STEMTera/STEMTera-Breadboard-B328/Enclosure/stemtera9_bottom_cover_part1.stl

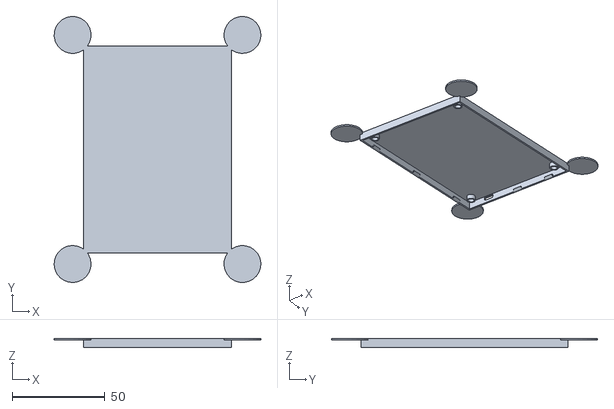
[picture p1: CAD file, 2017-02-02]
Enclosure/stemtera9_bottom_cover_part1.stl
111.8 x 143.8 x 5.10
