STEMTera/STEMTera-Breadboard-B328/(list of files, cad)

Other CAD files:
Enclosure/models/0805.skp
Enclosure/models/C0603.skp
Enclosure/models/C1206.skp
Enclosure/models/CONN_JACK_PJ-051A-SINGLE_SIDED.skp
Enclosure/models/CONN_JACK_PJ-051A.skp
Enclosure/models/CONN_USB_MICRO_B_10118193-0001LF.skp
Enclosure/models/CSTCE_V.skp
Enclosure/models/CT6032.skp
Enclosure/models/CT_CN0603.skp
Enclosure/models/DPACK.skp
Enclosure/models/HC49US-SMD-2.5MM.skp
Enclosure/models/HC49US-SMD.skp
Enclosure/models/L1812.skp
Enclosure/models/LED3MM.skp
Enclosure/models/LED3MMRND.skp
Enclosure/models/MINIMELF.skp
Enclosure/models/PUSH_BUTTON-ESWITCH_TL6120DF300QG.skp
Enclosure/models/QFN32.skp
Enclosure/models/R0603.skp
Enclosure/models/R1206.skp
Enclosure/models/SO08-150.skp
Enclosure/models/SO14.skp
Enclosure/models/SOIC08_3.8MM.skp
Enclosure/models/SOT-23.skp
Enclosure/models/SOT23-DBV.skp
Enclosure/models/SOT89.skp
Enclosure/models/SSOP28.skp
Enclosure/models/TQFP32-7MM_0.8MM.skp
Enclosure/models/TSSOP14.skp
