STEMTera/STEMTera-Breadboard-B328/Breadboard.pdf

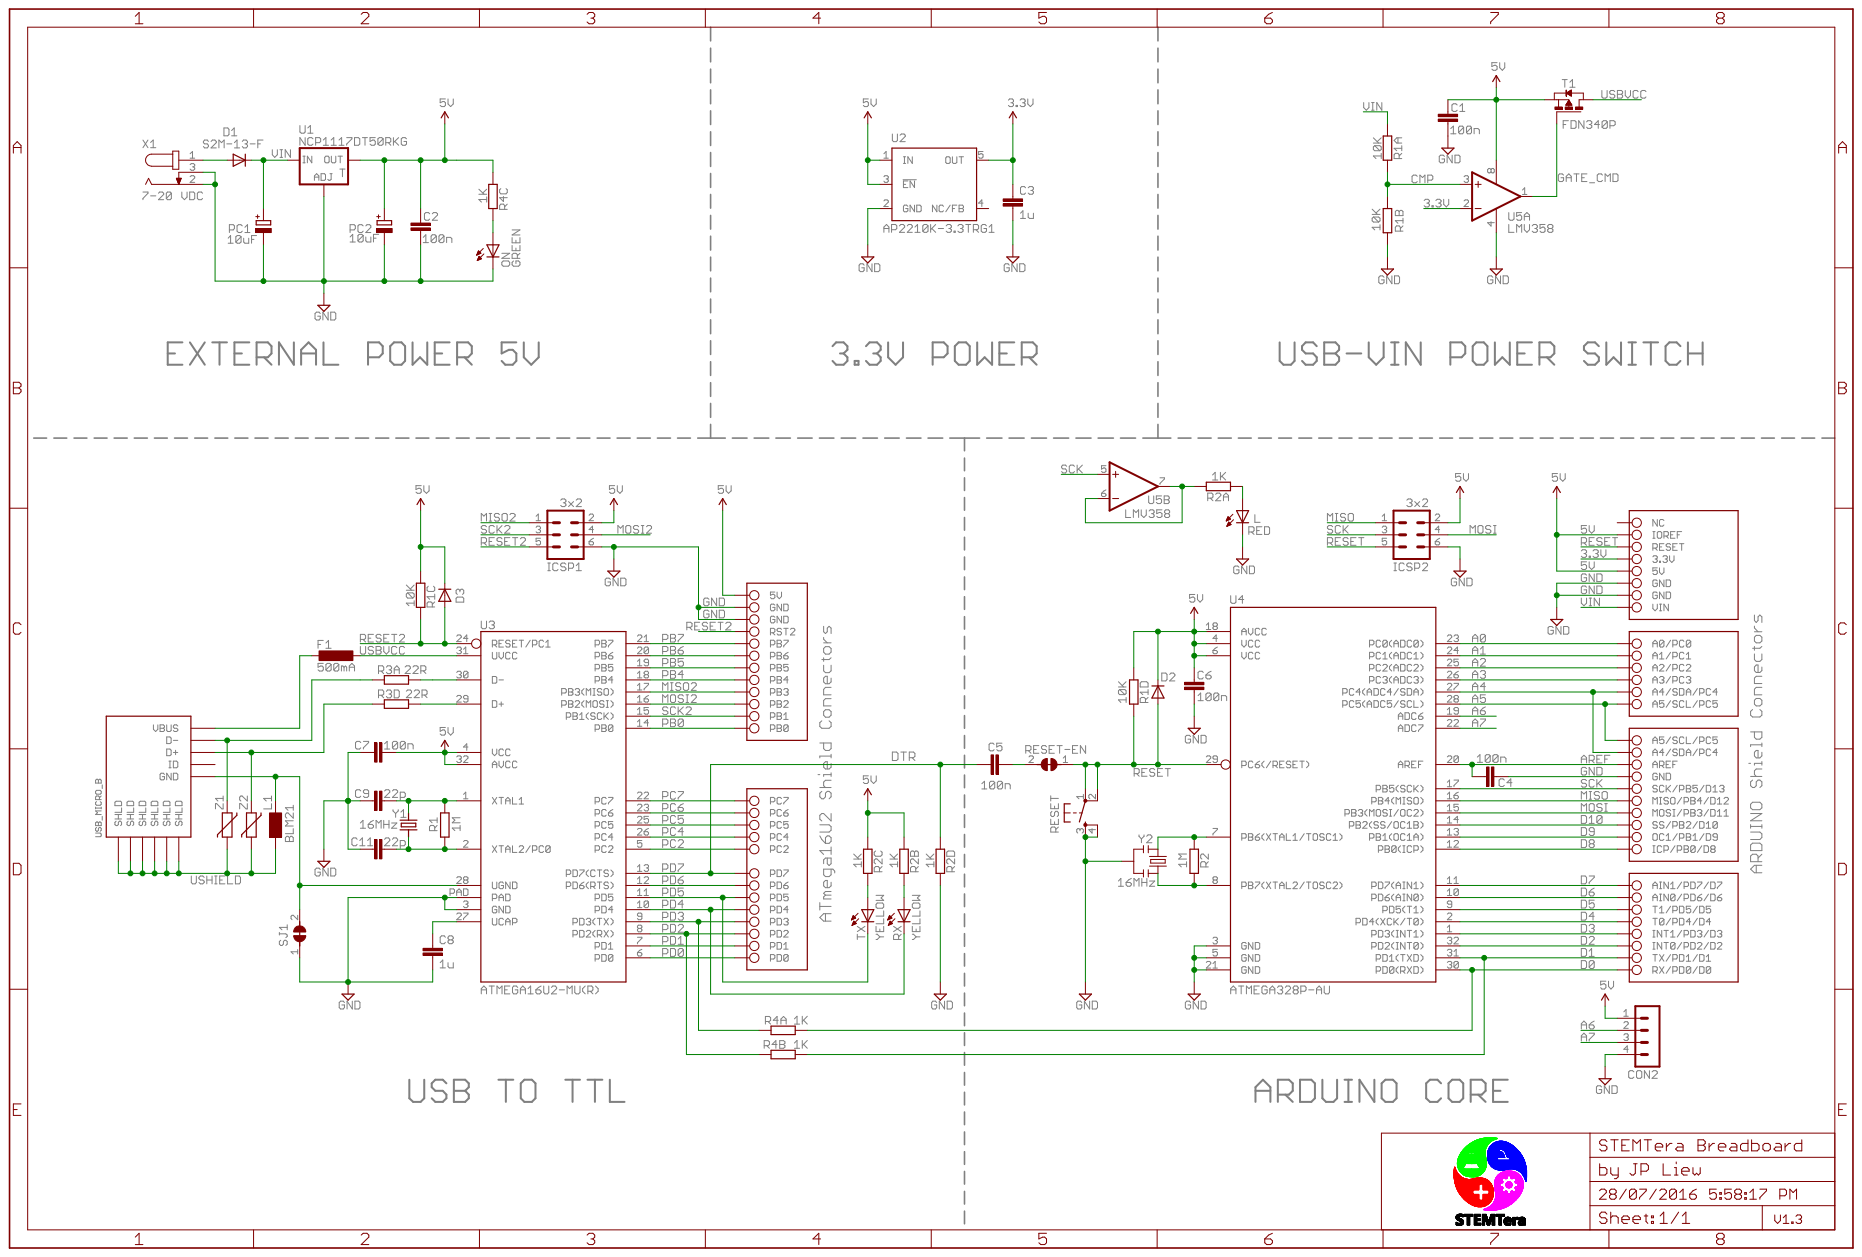
[picture p2: page 1]
