STEMTera/STEMTera-Breadboard-B328/Enclosure/STEMTera Breadboard Bottom Dimension.pdf

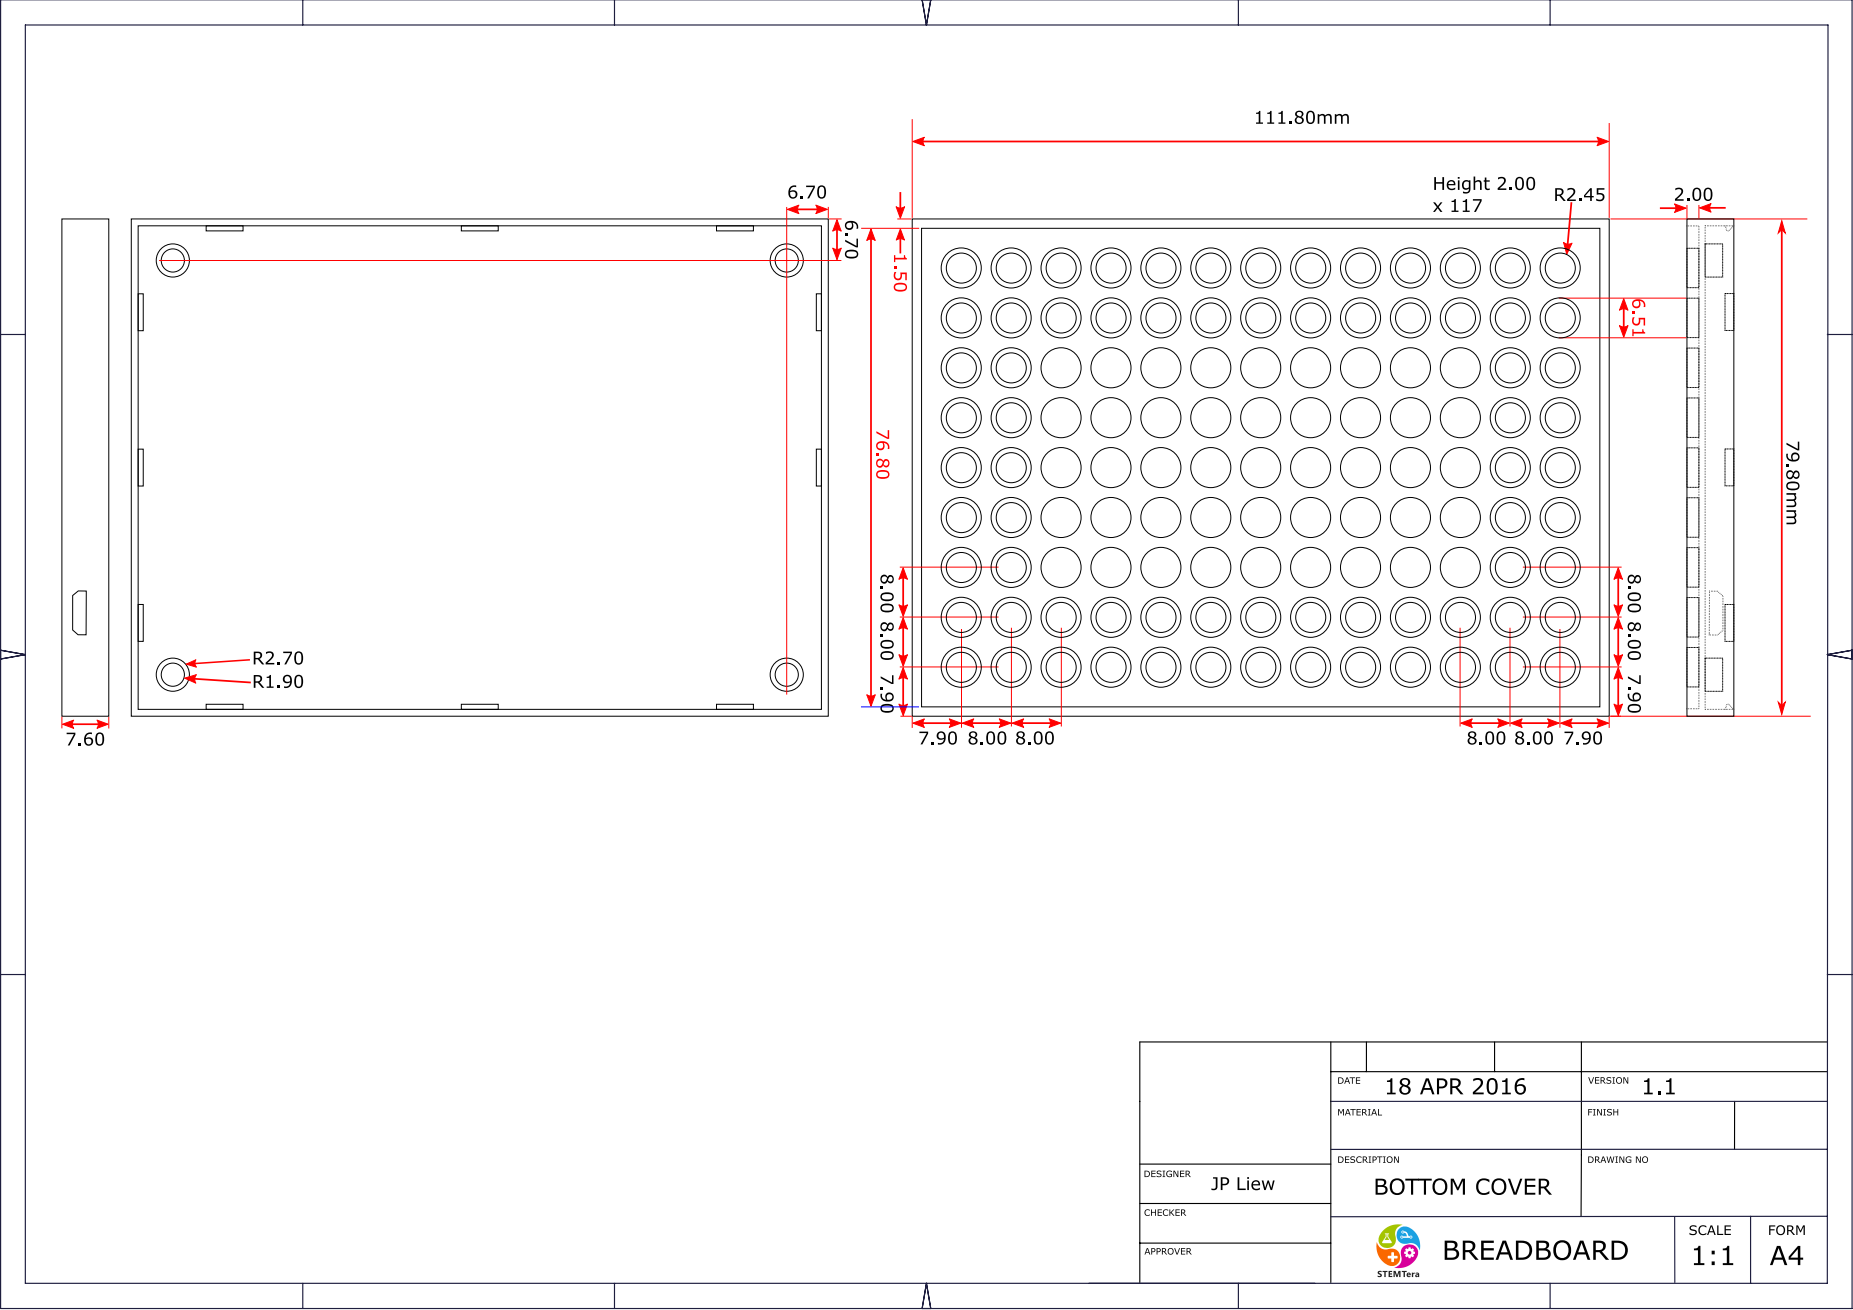
[picture p3: page 1]
