STEMTera/STEMTera-Breadboard-B328/Enclosure/STEMTera Breadboard Text.pdf

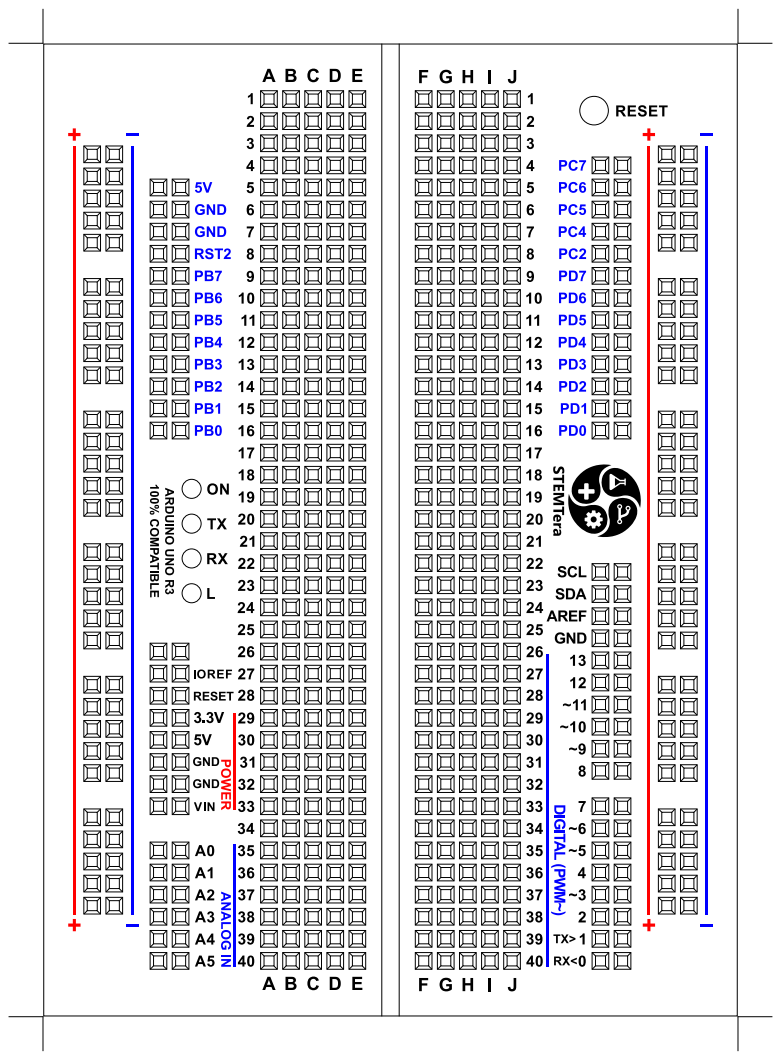
[picture p4: page 1]
