STEMTera/STEMTera-Breadboard-B328/Enclosure/STEMTera Breadboard Top Dimension.pdf

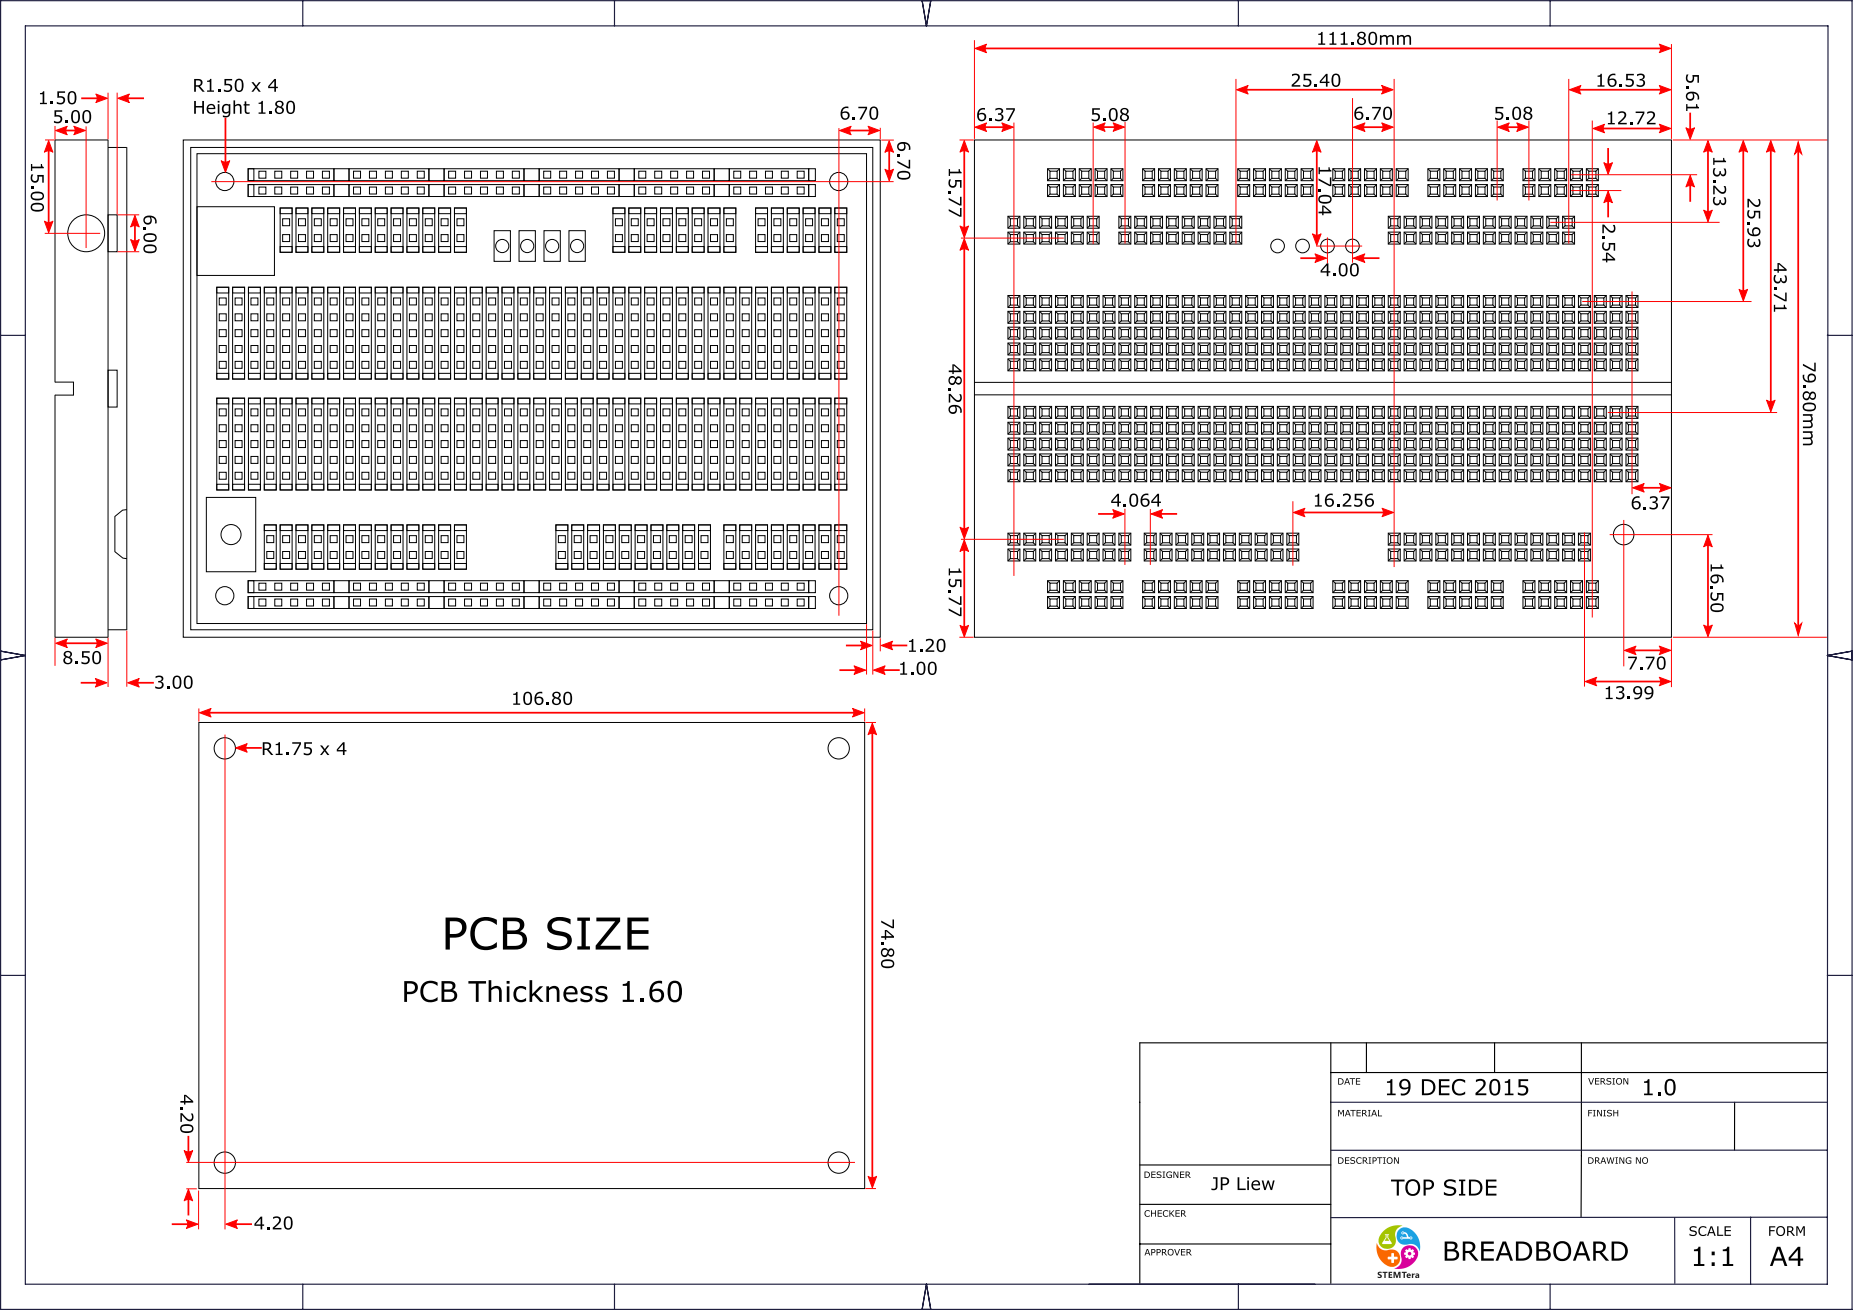
[picture p5: page 1]
