STEMTera/STEMTera-Breadboard-B328/Breadboard.brd

## EAGLE design Breadboard.brd (2017-02-02)

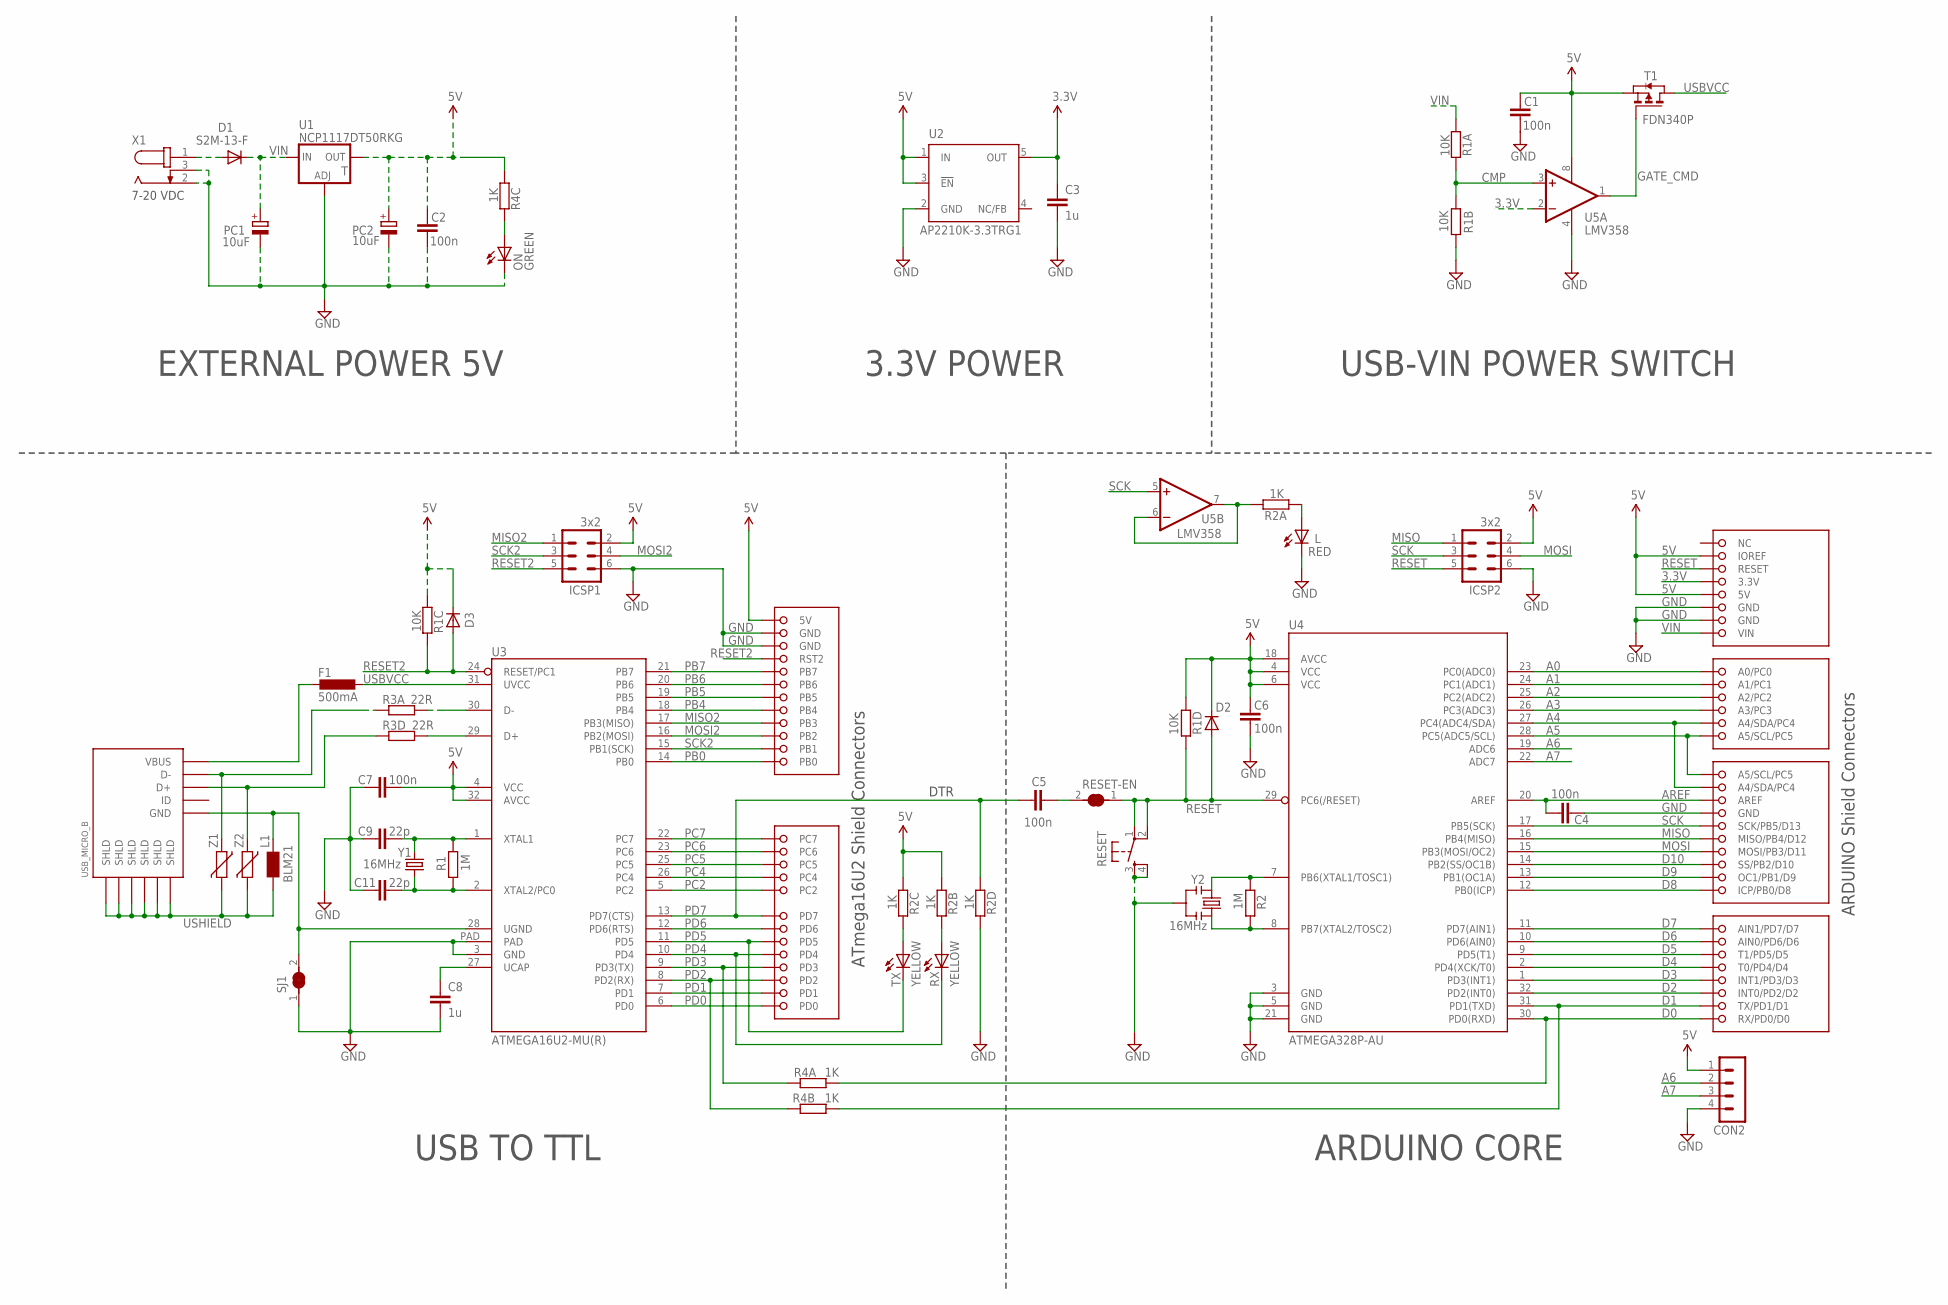
[picture p6: schematic Breadboard.sch]

Parts:
C1, C2, C4, C5, C6, C7: 100n; C0603; MPN CC0603KRX7R9BB104
C3, C8: 1u; C0603; MPN CC0603KRX5R6BB105
C9, C11: 22p; C0603; MPN 06035A220JAT2A
CON1: STEMTERA; MPN NOT INSTALLED
CON2: MA04-1; MA04-1-SMD
D1: S2M-13-F; SMB; MPN S2M-13-F
D2, D3: CD1206-S01575; MINIMELF; MPN CD1206-S01575
F1: 500mA; L1812; MPN MF-MSMF050-2
ICSP1, ICSP2: 3x2; MA03-2; MPN NOT INSTALLED
L: RED; LED3MM; MPN L-13ID
L1: BLM21; 0805; MPN BLM21PG221SN1D
ON: GREEN; LED3MM; MPN L-13GD
PC1, PC2: 10uF; CT6032; MPN T491C106M025AT7280
R1, R2: 1M; R0603; MPN RC0603FR-071ML
R1A, R1B, R1C, R1D: 10K; R0603; MPN RC0603FR-0710KL
R2A, R2B, R2C, R2D, R4A, R4B, R4C: 1K; R0603; MPN RC0603FR-071KL
R3A, R3D: 22R; R0603; MPN RC0603FR-0722RL
RESET: PUSH_BUTTON-ESWITCH_TL6120DF300QG
RESET-EN: Jumper; SOLDER_JUMPER_NC; MPN NOT INSTALLED
RX: YELLOW; LED3MM; MPN L-13YD
SJ1: Jumper; SOLDER_JUMPER_NC; MPN NOT INSTALLED
T1: FDN340P; SOT-23; MPN FDN340P
TX: YELLOW; LED3MM; MPN L-13YD
U1: NCP1117DT50RKG; DPACK; MPN NCP1117DT50RKG
U2: AP2210K-3.3TRG1; SOT23-DBV; MPN AP2210K-3.3TRG1
U3: ATMEGA16U2-MU(R); QFN32; MPN ATMEGA16U2-MU
U4: ATMEGA328P-AU; TQFP32-7MM_0.8MM; MPN ATmega328P-AUR
U5: LMV358; SOIC08_3.8MM; MPN LMV358SG-13
USB_MICRO_B: CONN_USB-FCI_10118193-0001LF; CONN_USB_MICRO_B_10118193-0001LF; MPN 10118193-0001LF
X1: CONN_JACK-SINGLE_SIDED; CONN_JACK_PJ-051A-SINGLE_SIDED
Y1: 16MHz; HC49US-SMD-2.5MM; MPN ABLS3-16.000MHZ-D4Y-T
Y2: 16MHz; CSTCE_V; MPN CSTCE16M0V53-R0
Z1, Z2: VARISTORCN0603; CT/CN0603; MPN CG0603MLC-05E

Connections:
3.3V: C3.1, CON1.3.3V, U2.5 (OUT), U5.2 (-IN)
5V: C1.2, C2.2, C6.2, C7.2, CON1.5V, CON1.5V@11 (5V), CON1.IOREF, CON2.1, D2.C, D3.C, ICSP1.2, ICSP2.2, PC2.+, R1C.2, R1D.2, R2B.2, R2C.2, R4C.2, T1.2 (S), U1.4 (OUT), U2.1 (IN), U2.3 (!EN), U3.4 (VCC), U3.32 (AVCC), U4.4 (VCC), U4.6 (VCC), U4.18 (AVCC), U5.8 (V+)
A0: CON1.A0 (A0/PC0), U4.23 (PC0(ADC0))
A1: CON1.A1 (A1/PC1), U4.24 (PC1(ADC1))
A2: CON1.A2 (A2/PC2), U4.25 (PC2(ADC2))
A3: CON1.A3 (A3/PC3), U4.26 (PC3(ADC3))
A4: CON1.A4@1 (A4/SDA/PC4), CON1.A4@2 (A4/SDA/PC4), U4.27 (PC4(ADC4/SDA))
A5: CON1.A5@1 (A5/SCL/PC5), CON1.A5@2 (A5/SCL/PC5), U4.28 (PC5(ADC5/SCL))
A6: CON2.2, U4.19 (ADC6)
A7: CON2.3, U4.22 (ADC7)
AREF: C4.2, CON1.AREF, U4.20 (AREF)
CMP: R1A.1, R1B.2, U5.3 (+IN)
D0: CON1.D0 (RX/PD0/D0), R4A.2, U4.30 (PD0(RXD))
D1: CON1.D1 (TX/PD1/D1), R4B.2, U4.31 (PD1(TXD))
D2: CON1.D2 (INT0/PD2/D2), U4.32 (PD2(INT0))
D3: CON1.D3 (INT1/PD3/D3), U4.1 (PD3(INT1))
D4: CON1.D4 (T0/PD4/D4), U4.2 (PD4(XCK/T0))
D5: CON1.D5 (T1/PD5/D5), U4.9 (PD5(T1))
D6: CON1.D6 (AIN0/PD6/D6), U4.10 (PD6(AIN0))
D7: CON1.D7 (AIN1/PD7/D7), U4.11 (PD7(AIN1))
D8: CON1.D8 (ICP/PB0/D8), U4.12 (PB0(ICP))
D9: CON1.D9 (OC1/PB1/D9), U4.13 (PB1(OC1A))
D10: CON1.D10 (SS/PB2/D10), U4.14 (PB2(SS/OC1B))
GATE_CMD: T1.3 (G), U5.1 (OUT)
GND: C1.1, C2.1, C3.2, C4.1, C6.1, C7.1, C8.2, C9.1, C11.1, CON1.GND@1 (GND), CON1.GND@2 (GND), CON1.GND@3 (GND), CON1.GND@11 (GND), CON1.GND@12 (GND), CON2.4, ICSP1.6, ICSP2.6, L.K (C), ON.K (C), PC1.-, PC2.-, R1B.1, R2D.1, RESET.3, RESET.4, SJ1.1, U1.1 (ADJ), U2.2 (GND), U3.3 (GND), U3.PAD, U4.3 (GND), U4.5 (GND), U4.21 (GND), U5.4 (V-), X1.2, X1.3, Y2.2
MISO: CON1.D12 (MISO/PB4/D12), ICSP2.1, U4.16 (PB4(MISO))
MISO2: CON1.PB3, ICSP1.1, U3.17 (PB3(MISO))
MOSI: CON1.D11 (MOSI/PB3/D11), ICSP2.4, U4.15 (PB3(MOSI/OC2))
MOSI2: CON1.PB2, ICSP1.4, U3.16 (PB2(MOSI))
unnamed: R2.2, U4.7 (PB6(XTAL1/TOSC1)), Y2.1
unnamed: R3A.1, USB_MICRO_B.D-, Z1.1
unnamed: R3D.1, USB_MICRO_B.D+, Z2.1
unnamed: C9.2, R1.2, U3.1 (XTAL1), Y1.2
unnamed: C8.1, U3.27 (UCAP)
unnamed: R3A.2, U3.30 (D-)
unnamed: C11.2, R1.1, U3.2 (XTAL2/PC0), Y1.1
unnamed: R3D.2, U3.29 (D+)
unnamed: R2.1, U4.8 (PB7(XTAL2/TOSC2)), Y2.3
unnamed: R2C.1, TX.A
unnamed: R2B.1, RX.A
unnamed: L.A, R2A.2
unnamed: D1.A, X1.1
unnamed: ON.A, R4C.1
unnamed: C5.2, RESET-EN.2
unnamed: R2A.1, U5.6 (-IN), U5.7 (OUT)
PB0: CON1.PB0, U3.14 (PB0)
PB4: CON1.PB4, U3.18 (PB4)
PB5: CON1.PB5, U3.19 (PB5)
PB6: CON1.PB6, U3.20 (PB6)
PB7: CON1.PB7, U3.21 (PB7)
PC2: CON1.PC2, U3.5 (PC2)
PC4: CON1.PC4, U3.26 (PC4)
PC5: CON1.PC5, U3.25 (PC5)
PC6: CON1.PC6, U3.23 (PC6)
PC7: CON1.PC7, U3.22 (PC7)
PD0: CON1.PD0, U3.6 (PD0)
PD1: CON1.PD1, U3.7 (PD1)
PD2: CON1.PD2, R4B.1, U3.8 (PD2(RX))
PD3: CON1.PD3, R4A.1, U3.9 (PD3(TX))
PD4: CON1.PD4, RX.K (C), U3.10 (PD4)
PD5: CON1.PD5, TX.K (C), U3.11 (PD5)
PD6: CON1.PD6, U3.12 (PD6(RTS))
PD7: C5.1, CON1.PD7, R2D.2, U3.13 (PD7(CTS))
RESET: CON1.RESET, D2.A, ICSP2.5, R1D.1, RESET.1, RESET.2, RESET-EN.1, U4.29 (PC6(/RESET))
RESET2: CON1.RST2, D3.A, ICSP1.5, R1C.1, U3.24 (RESET/PC1)
SCK: CON1.D13 (SCK/PB5/D13), ICSP2.3, U4.17 (PB5(SCK)), U5.5 (+IN)
SCK2: CON1.PB1, ICSP1.3, U3.15 (PB1(SCK))
UGND: L1.1, SJ1.2, U3.28 (UGND), USB_MICRO_B.GND
USBVCC: F1.1, T1.1 (D), U3.31 (UVCC)
USHIELD: L1.2, USB_MICRO_B.SHLD@1 (SHLD), USB_MICRO_B.SHLD@2 (SHLD), USB_MICRO_B.SHLD@3 (SHLD), USB_MICRO_B.SHLD@4 (SHLD), USB_MICRO_B.SHLD@5 (SHLD), USB_MICRO_B.SHLD@6 (SHLD), Z1.2, Z2.2
VBUS: F1.2, USB_MICRO_B.VBUS
VIN: CON1.VIN, D1.C, PC1.+, R1A.2, U1.3 (IN)

Notes on the sheet:
7-20 VDC
EXTERNAL POWER 5V
3.3V POWER
USB-VIN POWER SWITCH
USB TO TTL
ARDUINO CORE
ARDUINO Shield Connectors
ATmega16U2 Shield Connectors
DTR

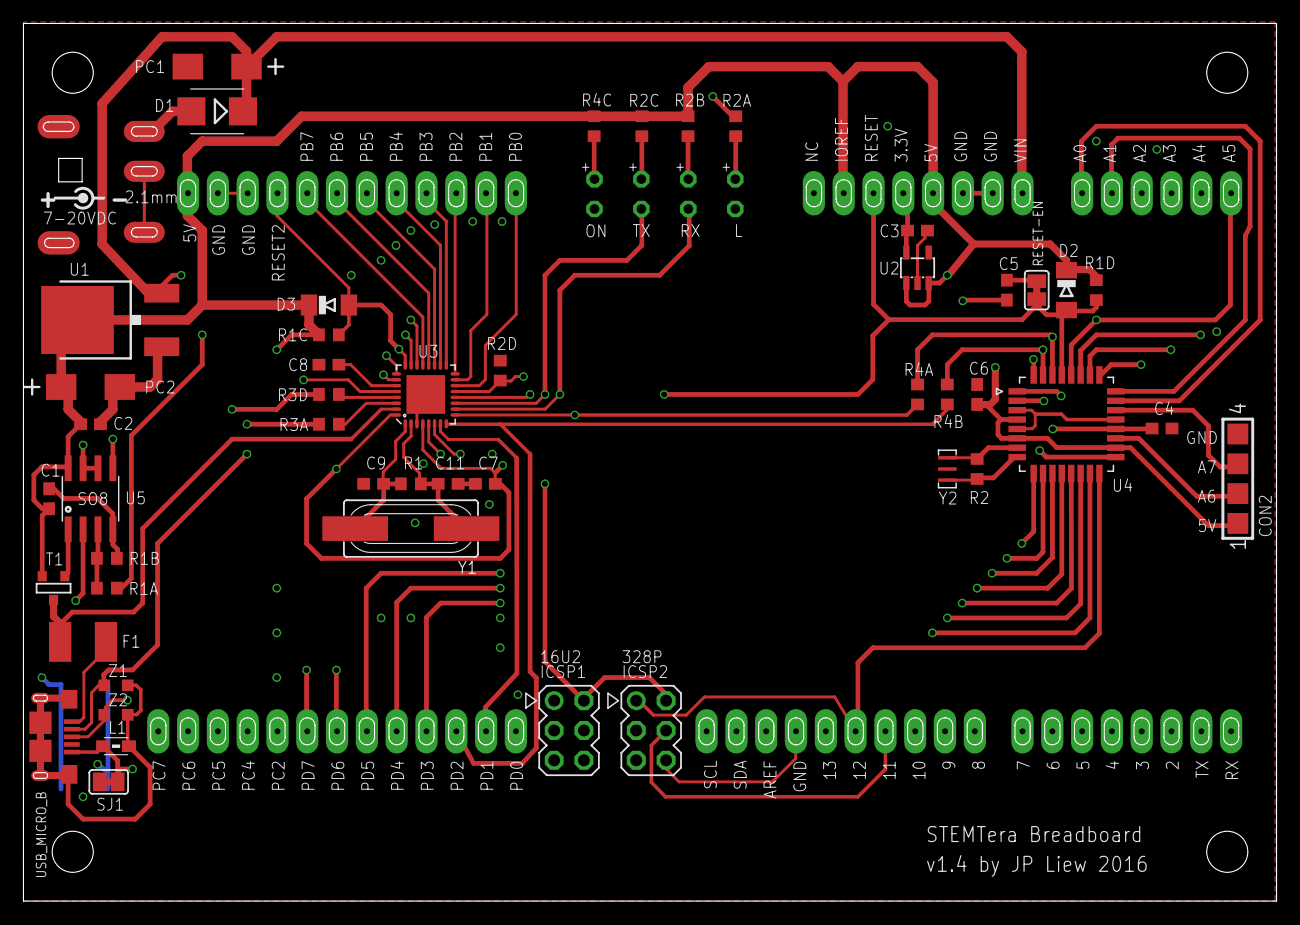
[picture p7: board Breadboard.brd from above]

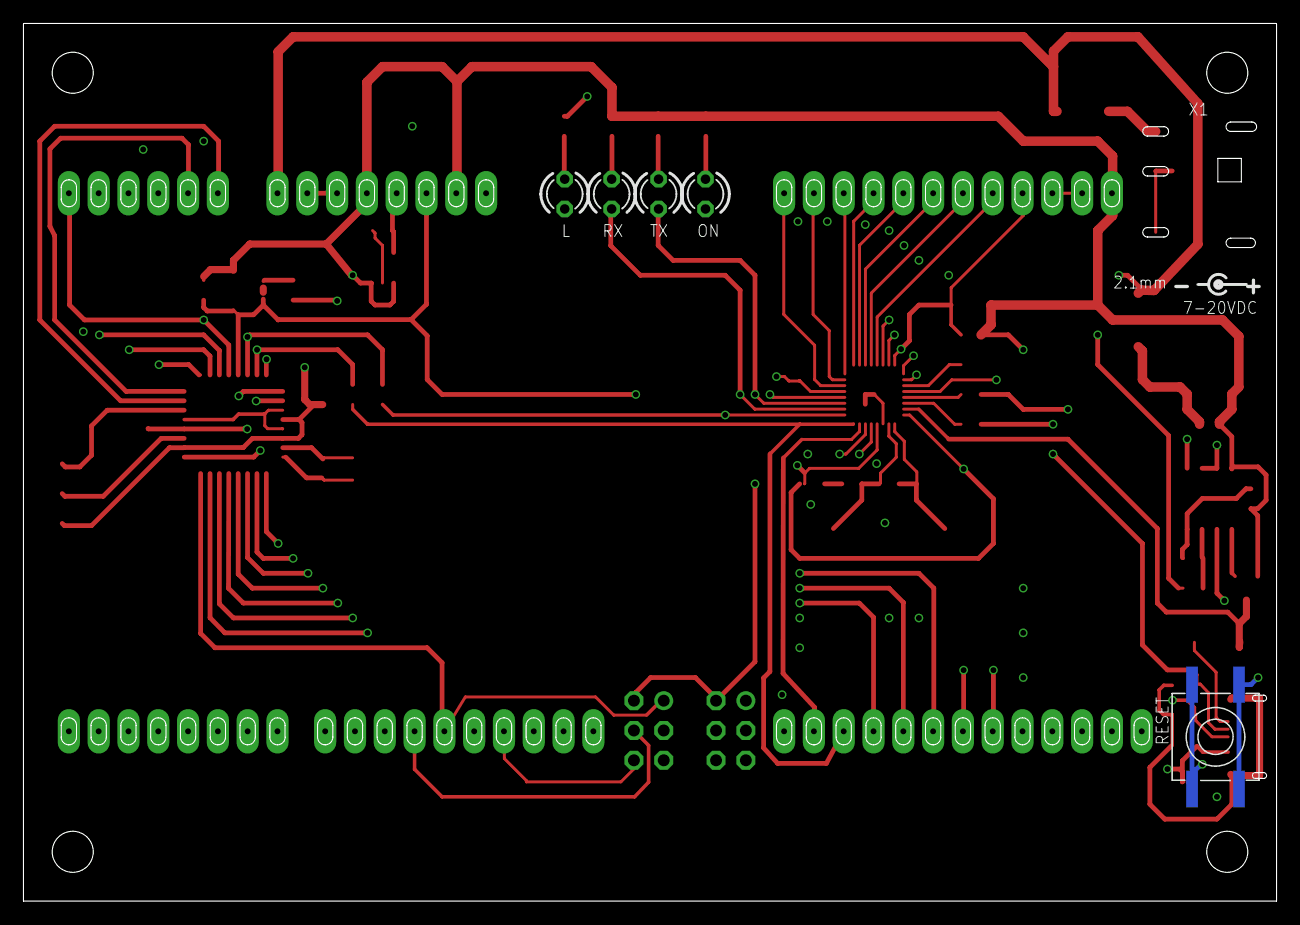
[picture p8: board Breadboard.brd from below]

Board: 4 copper layers, 106.8 x 74.8 mm, 55 parts (6 on the bottom side), 72 nets.
